tsowell/cobra-keyboard/README-ro.md

# Tastatura pentru Cobra

Acesta sunt fișiere KiCad pentru o tastatură pentru [calculatorul
Cobra](http://cobrasov.com).  E adaptat din [tastatura versiunea 1.0 din
cobrasov.com](http://cobrasov.com/CoBra%20Project/kbd1.0-ro.html).

Schimbările a fost necesare pentru a se adapta designul la orientarea și
dimensiunile [tastelor mele
personalizate](https://github.com/tsowell/cobra-keycaps).

NOTĂ: Încă această revizuire nu a fost testat.  După ce am comandat placa de
bază de [revizuirea anterioară][b5ad87d], am decis să schimb pozițiile tastelor
GRAPH și NEW MODE.

[b5ad87d]: https://github.com/tsowell/cobra-keyboard/tree/b5ad87d
