tsowell/cobra-keyboard/cobra_keyboard.kicad_pcb

## KiCad design cobra_keyboard.kicad_pcb (2022-08-24)

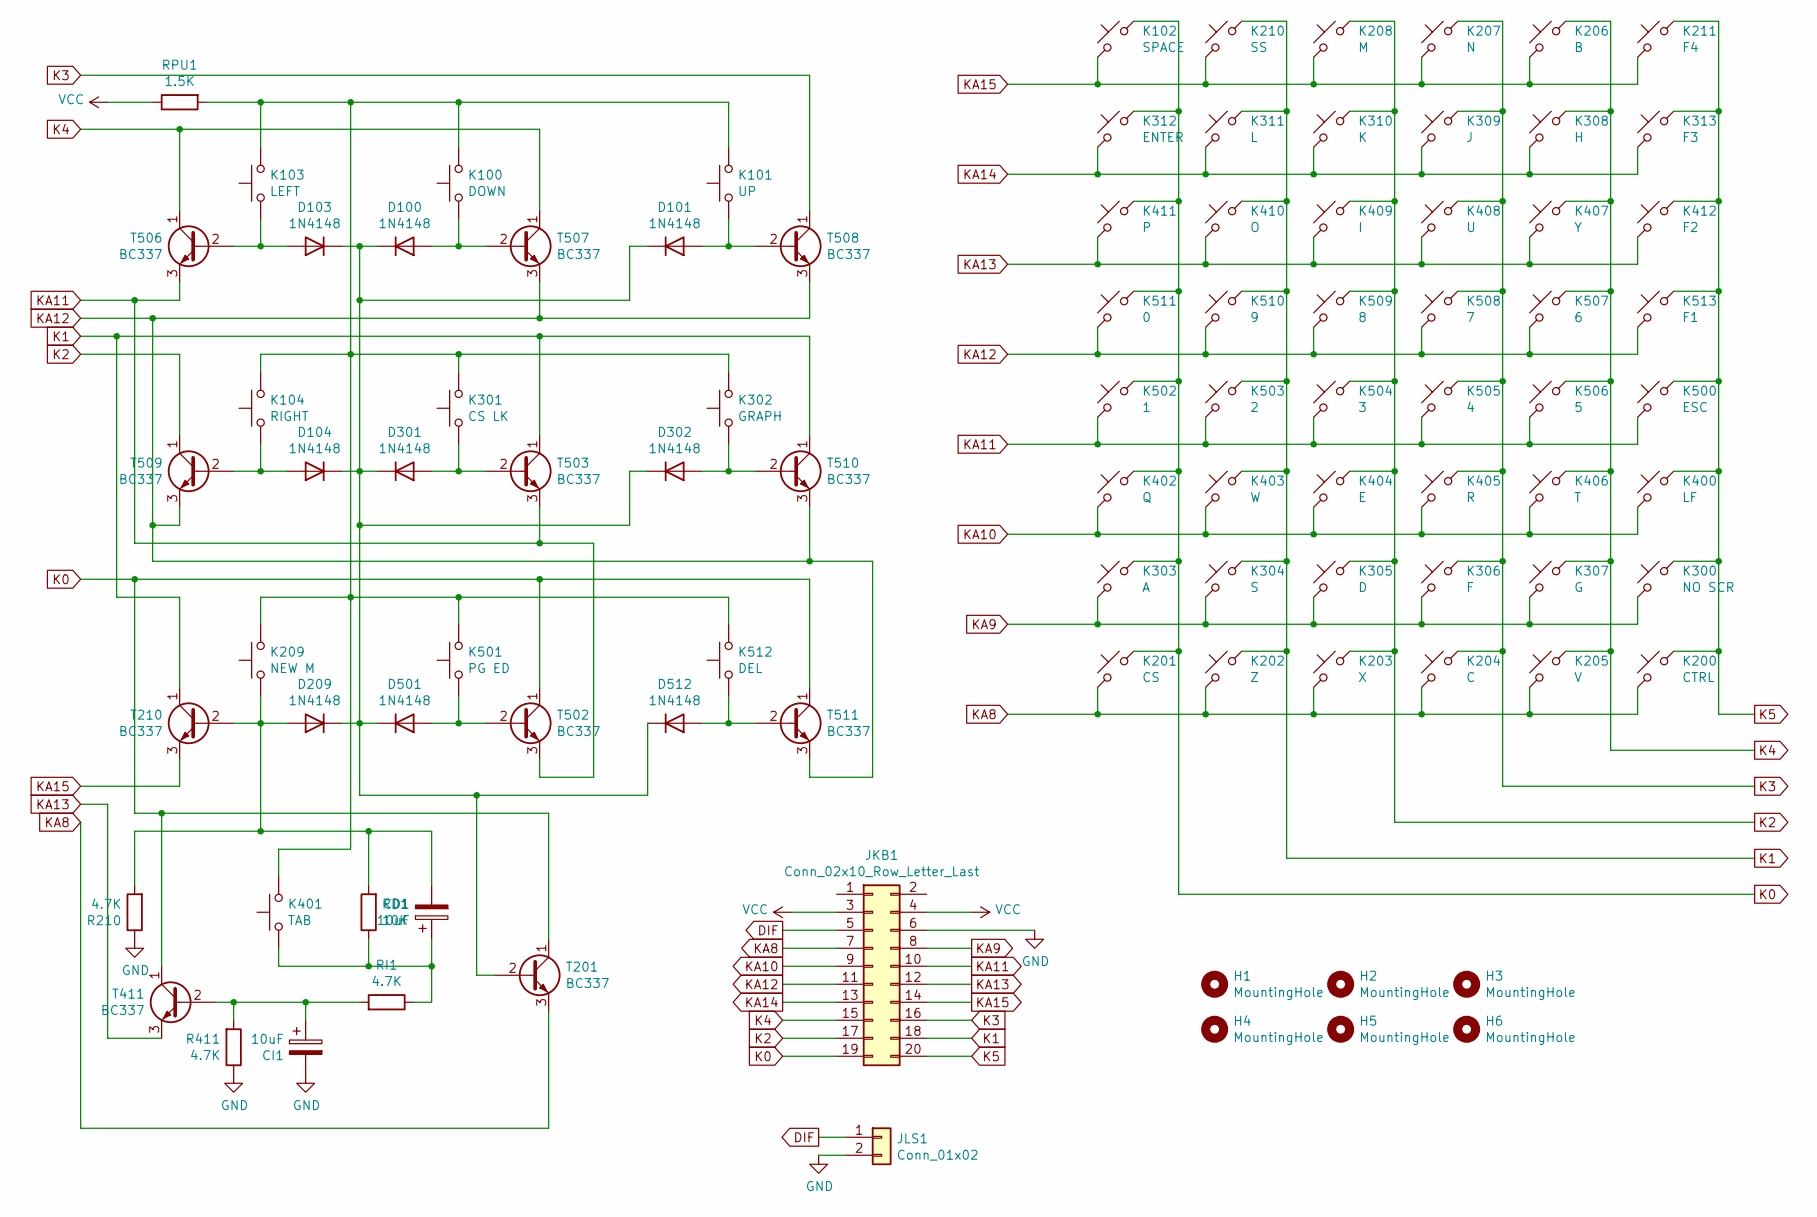
[picture p1: schematic cobra_keyboard.kicad_sch]

Parts:
CD1: 10uF; CP_Radial_D4.0mm_P1.50mm_Horizontal
CI1: 10uF; CP_Radial_D4.0mm_P1.50mm_Horizontal
D100, D101, D103, D104, D209, D301, D302, D501, D512: 1N4148; D_DO-35_SOD27_P7.62mm_Horizontal
H1, H2, H3, H4, H5, H6: MountingHole; MountingHole_3mm
JKB1: Conn_02x10_Row_Letter_Last; PinHeader_2x10_P2.54mm_Vertical
JLS1: Conn_01x02; PinHeader_1x02_P2.54mm_Vertical
K100: DOWN; SW_Cherry_MX_1.00u_PCB
K101: UP; SW_Cherry_MX_1.00u_PCB
K102: SPACE; SW_Cherry_MX_6.25u_PCB
K103: LEFT; SW_Cherry_MX_1.00u_PCB
K104: RIGHT; SW_Cherry_MX_1.00u_PCB
K200: CTRL; SW_Cherry_MX_1.00u_PCB
K201: CS; SW_Cherry_MX_2.25u_PCB
K202: Z; SW_Cherry_MX_1.00u_PCB
K203: X; SW_Cherry_MX_1.00u_PCB
K204: C; SW_Cherry_MX_1.00u_PCB
K205: V; SW_Cherry_MX_1.00u_PCB
K206: B; SW_Cherry_MX_1.00u_PCB
K207: N; SW_Cherry_MX_1.00u_PCB
K208: M; SW_Cherry_MX_1.00u_PCB
K209: NEW M; SW_Cherry_MX_1.00u_PCB
K210: SS; SW_Cherry_MX_2.75u_PCB
K211: F4; SW_Cherry_MX_1.00u_PCB
K300: NO SCR; SW_Cherry_MX_1.00u_PCB
K301: CS LK; SW_Cherry_MX_1.75u_PCB
K302: GRAPH; SW_Cherry_MX_1.50u_PCB
K303: A; SW_Cherry_MX_1.00u_PCB
K304: S; SW_Cherry_MX_1.00u_PCB
K305: D; SW_Cherry_MX_1.00u_PCB
K306: F; SW_Cherry_MX_1.00u_PCB
K307: G; SW_Cherry_MX_1.00u_PCB
K308: H; SW_Cherry_MX_1.00u_PCB
K309: J; SW_Cherry_MX_1.00u_PCB
K310: K; SW_Cherry_MX_1.00u_PCB
K311: L; SW_Cherry_MX_1.00u_PCB
K312: ENTER; SW_Cherry_MX_2.25u_PCB
K313: F3; SW_Cherry_MX_1.00u_PCB
K400: LF; SW_Cherry_MX_1.00u_PCB
K401: TAB; SW_Cherry_MX_1.50u_PCB
K402: Q; SW_Cherry_MX_1.00u_PCB
K403: W; SW_Cherry_MX_1.00u_PCB
K404: E; SW_Cherry_MX_1.00u_PCB
K405: R; SW_Cherry_MX_1.00u_PCB
K406: T; SW_Cherry_MX_1.00u_PCB
K407: Y; SW_Cherry_MX_1.00u_PCB
K408: U; SW_Cherry_MX_1.00u_PCB
K409: I; SW_Cherry_MX_1.00u_PCB
K410: O; SW_Cherry_MX_1.00u_PCB
K411: P; SW_Cherry_MX_1.00u_PCB
K412: F2; SW_Cherry_MX_1.00u_PCB
K500: ESC; SW_Cherry_MX_1.00u_PCB
K501: PG ED; SW_Cherry_MX_1.00u_PCB
K502: 1; SW_Cherry_MX_1.00u_PCB
K503: 2; SW_Cherry_MX_1.00u_PCB
K504: 3; SW_Cherry_MX_1.00u_PCB
K505: 4; SW_Cherry_MX_1.00u_PCB
K506: 5; SW_Cherry_MX_1.00u_PCB
K507: 6; SW_Cherry_MX_1.00u_PCB
K508: 7; SW_Cherry_MX_1.00u_PCB
K509: 8; SW_Cherry_MX_1.00u_PCB
K510: 9; SW_Cherry_MX_1.00u_PCB
K511: 0; SW_Cherry_MX_1.00u_PCB
K512: DEL; SW_Cherry_MX_2.00u_PCB
K513: F1; SW_Cherry_MX_1.00u_PCB
R210, R411: 4.7K; R_Axial_DIN0204_L3.6mm_D1.6mm_P7.62mm_Horizontal
RD1: 10K; R_Axial_DIN0204_L3.6mm_D1.6mm_P7.62mm_Horizontal
RI1: 4.7K; R_Axial_DIN0204_L3.6mm_D1.6mm_P7.62mm_Horizontal
RPU1: 1.5K; R_Axial_DIN0204_L3.6mm_D1.6mm_P7.62mm_Horizontal
T201, T210, T411, T502, T503, T506, T507, T508, T509, T510, T511: BC337; TO-92_Inline_Wide_Horizontal1

Connections:
DIF: JKB1.5, JLS1.1
GND: CI1.2, JKB1.6, JLS1.2, R210.1, R411.1
K0: JKB1.19, K102.2, K201.2, K303.2, K312.2, K402.2, K411.2, K502.2, K511.2, T201.1 (C), T411.1 (C), T502.1 (C), T511.1 (C)
K1: JKB1.18, K202.2, K210.2, K304.2, K311.2, K403.2, K410.2, K503.2, K510.2, T210.1 (C), T503.1 (C), T510.1 (C)
K2: JKB1.17, K203.2, K208.2, K305.2, K310.2, K404.2, K409.2, K504.2, K509.2, T509.1 (C)
K3: JKB1.16, K204.2, K207.2, K306.2, K309.2, K405.2, K408.2, K505.2, K508.2, T508.1 (C)
K4: JKB1.15, K205.2, K206.2, K307.2, K308.2, K406.2, K407.2, K506.2, K507.2, T506.1 (C), T507.1 (C)
K5: JKB1.20, K200.2, K211.2, K300.2, K313.2, K400.2, K412.2, K500.2, K513.2
KA8: JKB1.7, K200.1, K201.1, K202.1, K203.1, K204.1, K205.1, T201.3 (E)
KA9: JKB1.8, K300.1, K303.1, K304.1, K305.1, K306.1, K307.1
KA10: JKB1.9, K400.1, K402.1, K403.1, K404.1, K405.1, K406.1
KA11: JKB1.10, K500.1, K502.1, K503.1, K504.1, K505.1, K506.1, T502.3 (E), T503.3 (E), T506.3 (E)
KA12: JKB1.11, K507.1, K508.1, K509.1, K510.1, K511.1, K513.1, T507.3 (E), T508.3 (E), T509.3 (E), T510.3 (E), T511.3 (E)
KA13: JKB1.12, K407.1, K408.1, K409.1, K410.1, K411.1, K412.1, T411.3 (E)
KA14: JKB1.13, K308.1, K309.1, K310.1, K311.1, K312.1, K313.1
KA15: JKB1.14, K102.1, K206.1, K207.1, K208.1, K210.1, K211.1, T210.3 (E)
unnamed: CD1.1, K401.1, RD1.1, RI1.1
unnamed: CD1.2, D209.2 (A), K209.1, R210.2, RD1.2, T210.2 (B)
unnamed: CI1.1, R411.2, RI1.2, T411.2 (B)
unnamed: D100.1 (K), D101.1 (K), D103.1 (K), D104.1 (K), D209.1 (K), D301.1 (K), D302.1 (K), D501.1 (K), D512.1 (K), T201.2 (B)
unnamed: D100.2 (A), K100.1, T507.2 (B)
unnamed: D101.2 (A), K101.1, T508.2 (B)
unnamed: D103.2 (A), K103.1, T506.2 (B)
unnamed: D104.2 (A), K104.1, T509.2 (B)
unnamed: D301.2 (A), K301.1, T503.2 (B)
unnamed: D302.2 (A), K302.1, T510.2 (B)
unnamed: D501.2 (A), K501.1, T502.2 (B)
unnamed: D512.2 (A), K512.1, T511.2 (B)
unnamed: K100.2, K101.2, K103.2, K104.2, K209.2, K301.2, K302.2, K401.2, K501.2, K512.2, RPU1.2
VCC: JKB1.3, JKB1.4, RPU1.1

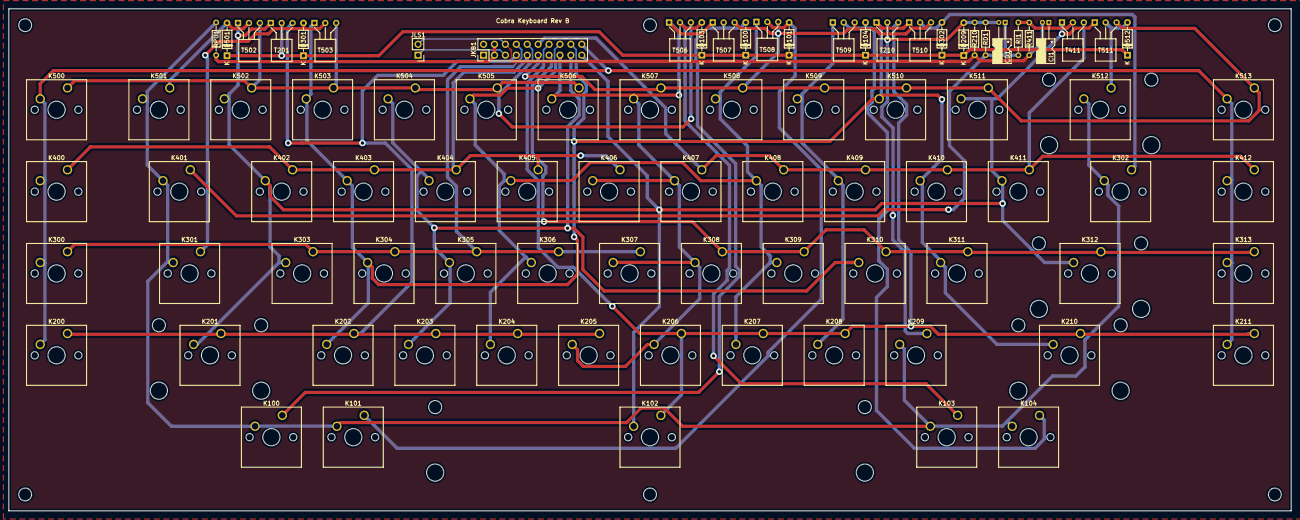
[picture p2: board cobra_keyboard.kicad_pcb from above]

Board: 2 copper layers, 298.4 x 116.8 mm, 93 parts (0 on the bottom side), 30 nets.
